Pavankarnat/pavanaluteck/backend/app/assets/straight_bars.stp

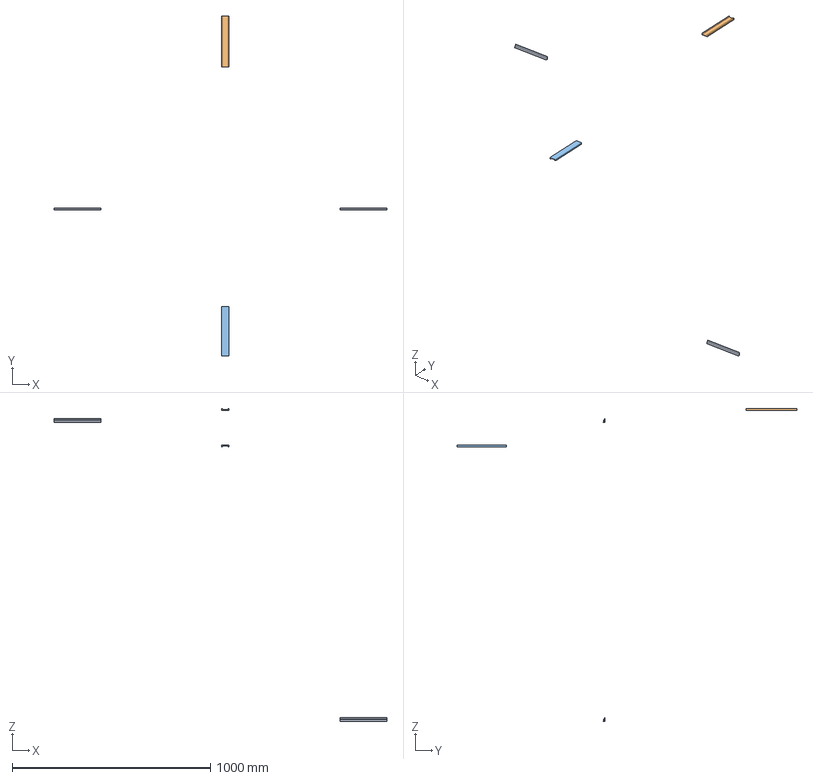
[picture p1: CAD file, 2026-10-18]
backend/app/assets/straight_bars.stp
1676.0 x 1713.0 x 1577.5 mm
