Pavankarnat/pavanaluteck/frontend/public/main/804-125-30-noha-1.stp

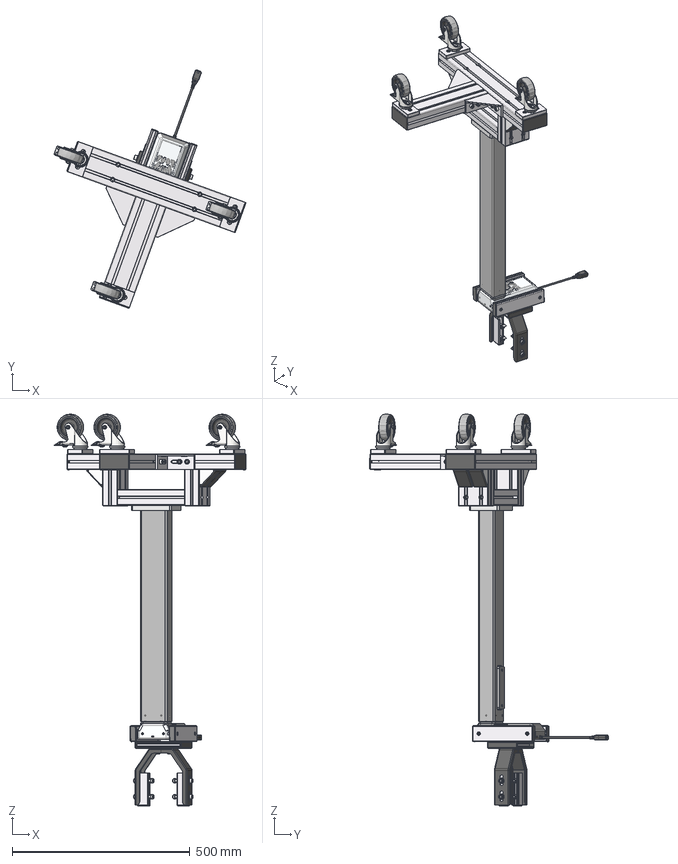
[picture p2: CAD file, 2026-10-18]
frontend/public/main/804-125-30-noha-1.stp
540.1 x 671.4 x 1103.4 mm
804-125-Linak_DL5_with_bracket
804-125-104590L-5
507508-obruč x 3
507508-ráfek x 3
507508-vložka x 3
517508-brzda x 3
517508-nosič-brzda x 3
517508-točna-brzda x 3
subdod. x 3
804-125-30-noha-1-104590L-1
804-125-30-noha-1-104590L-4
804-125-30-noha-1-104590L-4-01
804-125-30-noha-1-104590L-5
304343Z x 4
