Pavankarnat/pavanaluteck/frontend/public/reference-model/804-125.stp

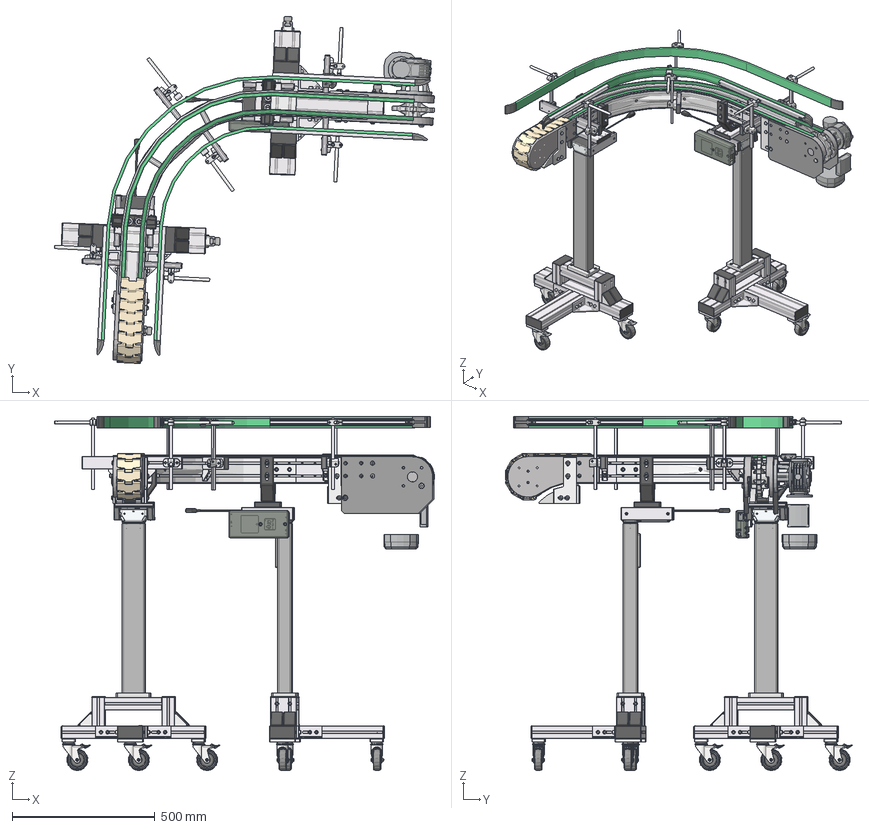
[picture p3: CAD file, 2026-10-18]
frontend/public/reference-model/804-125.stp
1331.6 x 1216.3 x 1241.0 mm
ARS 12160_1
ARD 12160_1 x 2
ARU30086
Kolo-I_1 x 3
Matice M6-10x10 x 8
Držák vodítka x 4
Deska vodítka x 2
Vodítko
Vodítko_1
AC645086-2
AC645086-1
804-125-904516A-780-1 x 2
804-125-904516B-780-1
804-125-904516B-780
804-125-904516A-25 x 2
804-125-904516A-200 x 2
DIN 125 - A 8.4 x 6
804-125-Linak_DL5_with_bracket x 2
804-125-104590L-5 x 2
507508-obruč x 6
507508-ráfek x 6
507508-vložka x 6
517508-brzda x 6
517508-nosič-brzda x 6
517508-točna-brzda x 6
subdod. x 6
804-125-30-noha-1-104590L-1 x 2
804-125-30-noha-1-104590L-4 x 2
804-125-30-noha-1-104590L-4-01 x 2
804-125-30-noha-1-104590L-5 x 2
304343Z x 8
ATS 12160_1
ATU30086
Kolo-I
Vodítko_2
Vodítko_3
Krycí plech hlavy x 2
ISO 7380 - M10 x 16
804-125-Linak_CBD6s
804-125-Linak_DPA
804-125-pohon_F1
