Pavankarnat/pavanaluteck/frontend/public/main/804-125-901020-150-2.stp

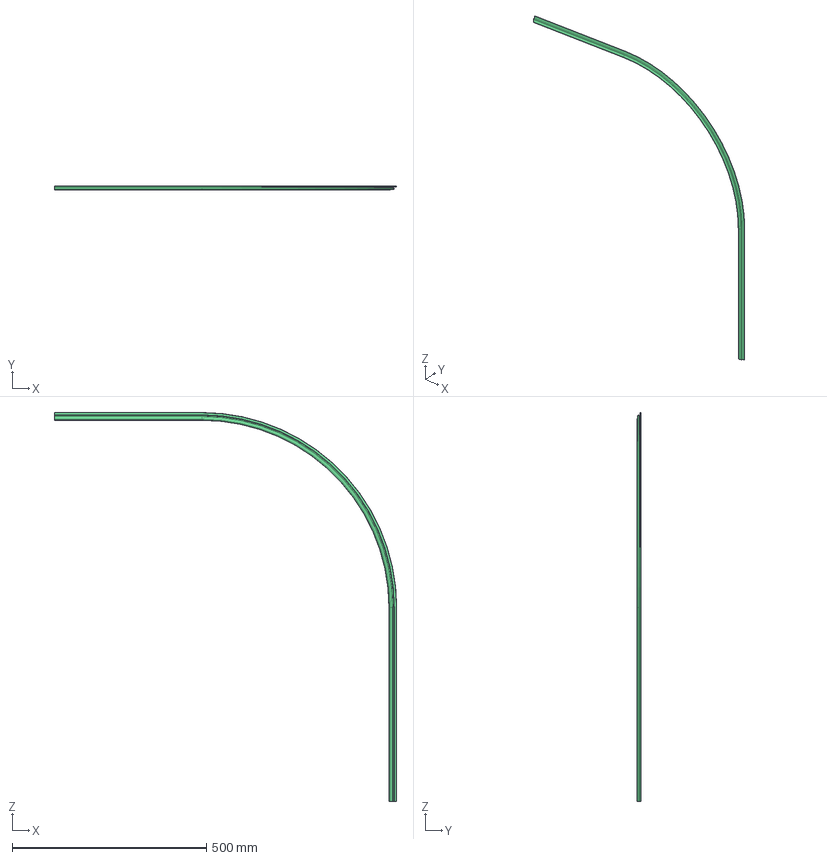
[picture p4: CAD file, 2026-10-18]
frontend/public/main/804-125-901020-150-2.stp
882.0 x 10.0 x 1002.0 mm
