Pavankarnat/pavanaluteck/frontend/public/main/804-125_108692_16.stp

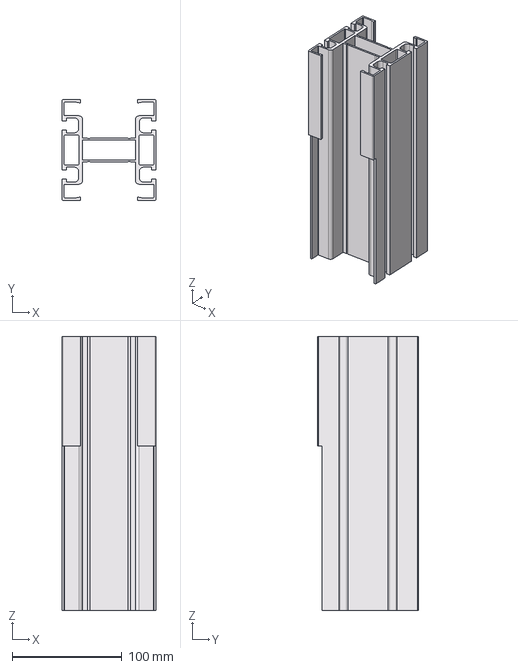
[picture p5: CAD file, 2026-10-18]
frontend/public/main/804-125_108692_16.stp
86.0 x 92.0 x 250.0 mm
