Pavankarnat/pavanaluteck/frontend/public/main/804-125-pohon_F1.stp

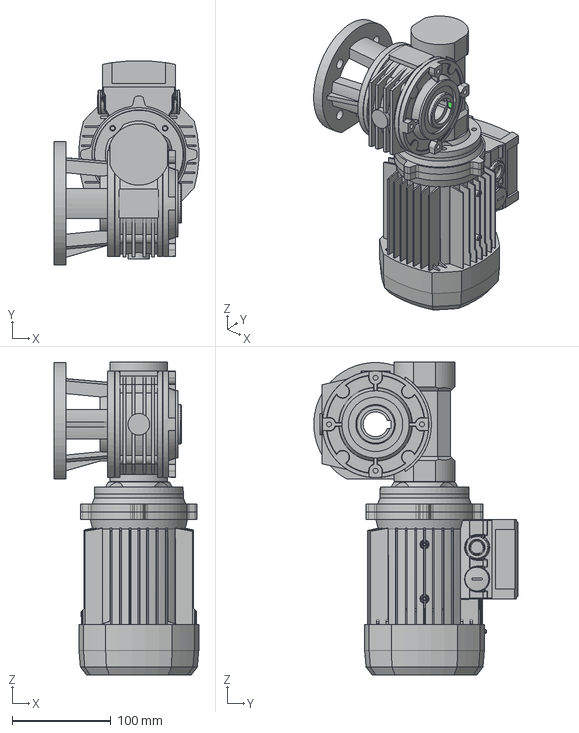
[picture p6: CAD file, 2026-10-18]
frontend/public/main/804-125-pohon_F1.stp
146.2 x 206.8 x 316.5 mm
