Pavankarnat/pavanaluteck/frontend/public/main/804-125-904516A-780-1.stp

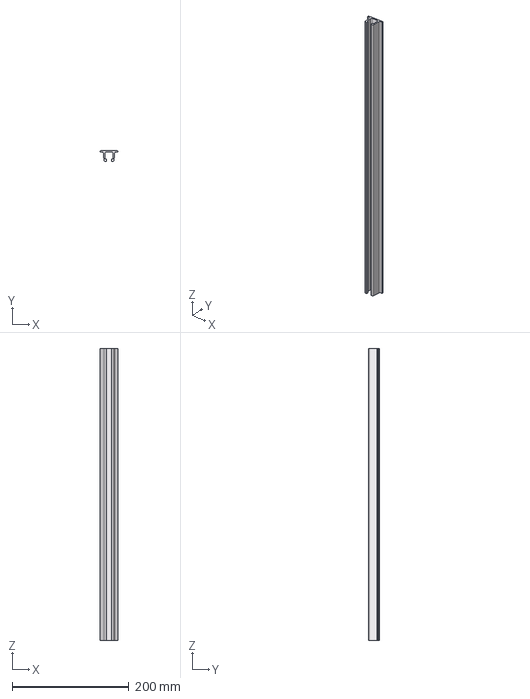
[picture p7: CAD file, 2026-10-18]
frontend/public/main/804-125-904516A-780-1.stp
30.0 x 18.5 x 500.0 mm
