Pavankarnat/pavanaluteck/frontend/public/main/804-125-8.stp

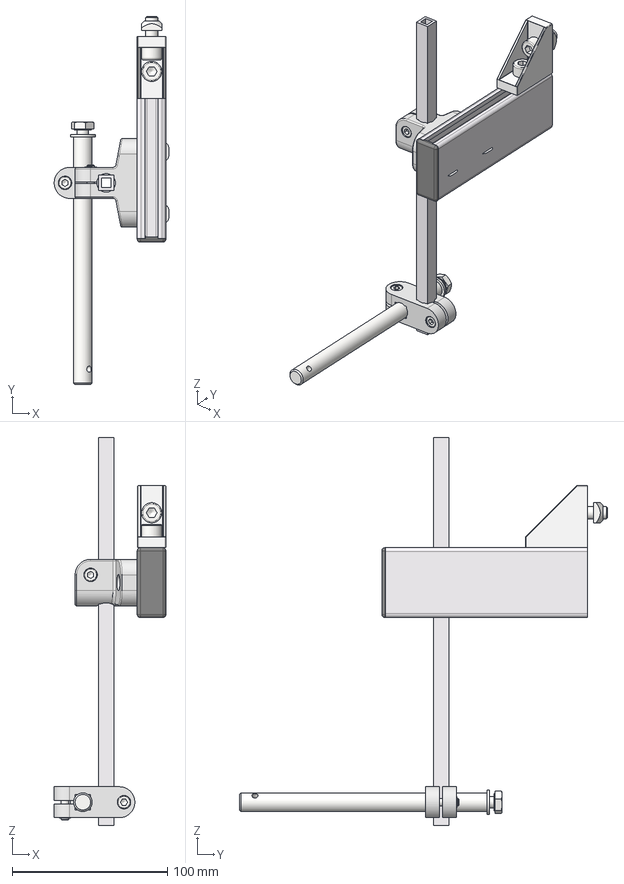
[picture p8: CAD file, 2026-10-18]
frontend/public/main/804-125-8.stp
73.9 x 237.3 x 250.0 mm
DIN 125 - A 8.4
