Pavankarnat/pavanaluteck/frontend/public/main/804-125-ATS12086S.stp

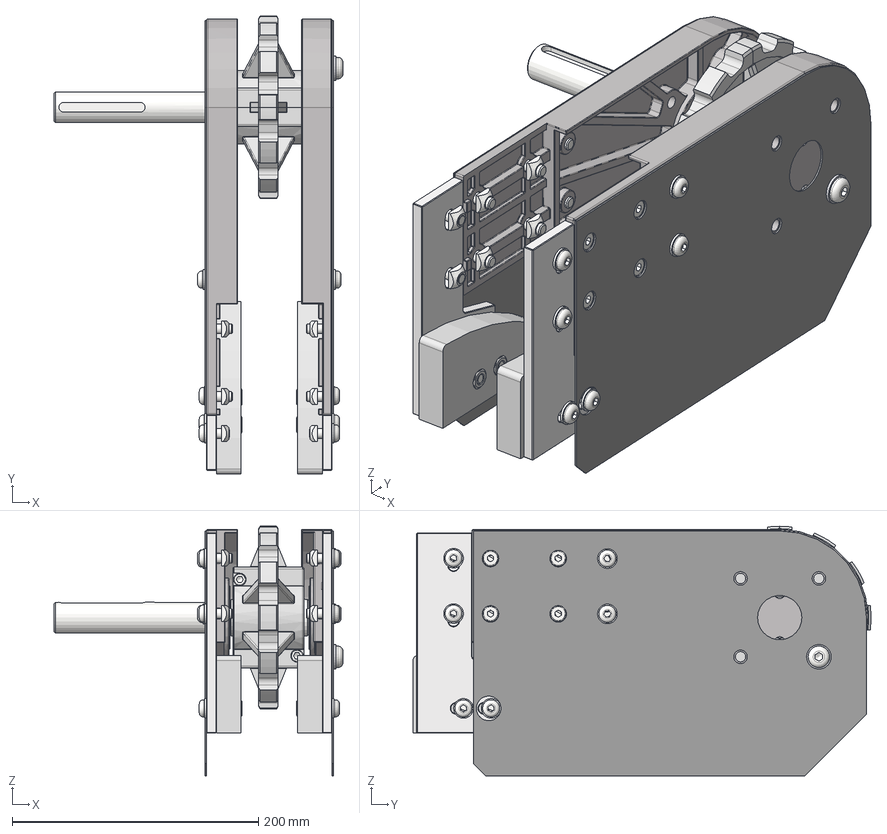
[picture p10: CAD file, 2026-10-18]
frontend/public/main/804-125-ATS12086S.stp
234.8 x 372.2 x 202.8 mm
ARD 12160_1
ATS 12160_1
ATU30086
Kolo-I
Kolo-I_1
Matice M6-10x10 x 4
Držák vodítka x 2
Vodítko
Vodítko_1
Krycí plech hlavy x 2
ISO 7380 - M10 x 16
