Pavankarnat/pavanaluteck/frontend/public/main/804-125-904516B-780-1.stp

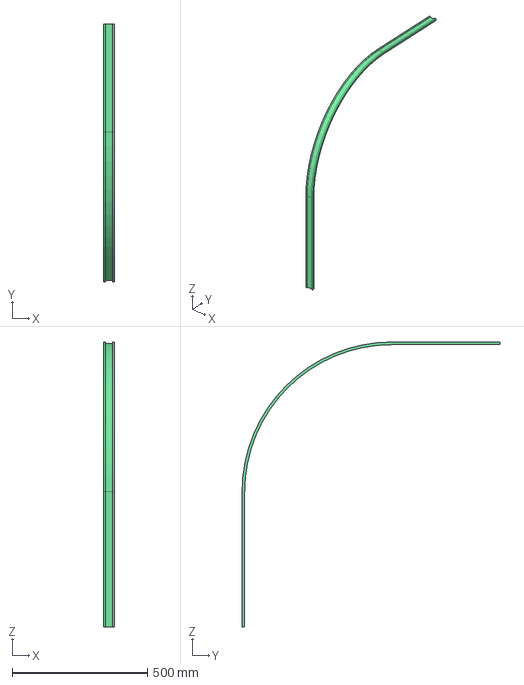
[picture p11: CAD file, 2026-10-18]
frontend/public/main/804-125-904516B-780-1.stp
40.0 x 953.5 x 1053.5 mm
