Pavankarnat/pavanaluteck/frontend/public/main/804-125-S 6 12 041-vratná.stp

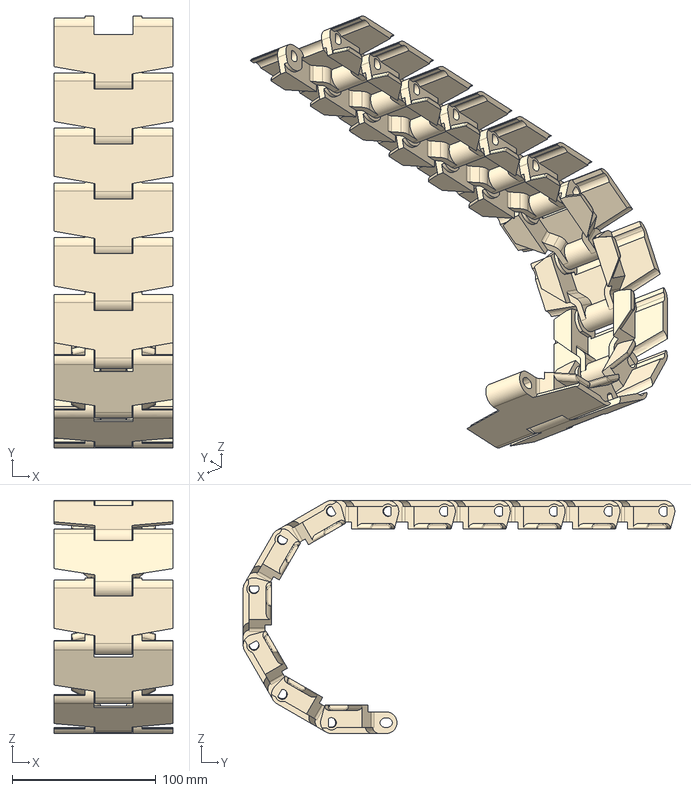
[picture p12: CAD file, 2026-10-18]
frontend/public/main/804-125-S 6 12 041-vratná.stp
82.5 x 299.9 x 161.9 mm
