Pavankarnat/pavanaluteck/(commit log)

2026-10-18 ALUFLEX conveyor configurator: 3D view and STEP export built from the client's exact CAD parts
    Composes straight and multi-bend conveyors from the client's reference STEP (804-125.stp):
    parts are moved, bars stretched, stands and posts repeated; the 3D view applies the same layout
    to the converted model. Includes tests, Docker setup and backend hardening.
2026-10-21 Chain width stretching of the client's parts, footing options, double-rail guide, cleaner stands, UI clean-up
    - widen / narrow the client's own parts for any chain width (63-304.8 mm): chain and links, crossbars, plates, bend rails
    - stands handled in their own frame; castors, brackets and fittings stay attached; moves from height / width / guides are combined
    - foot options (with / without brake, no castors), guide end caps follow guide height, double-rail guide
    - one stand where two bends are close together; controller placed beside the drive-end stand
    - removed travel-direction control, Flow button and CAD status chips
